ZT231/robotic-arm-vision-stm32/docs/舵机标定记录.md

# 机械臂舵机标定记录

> 本文档记录六路舵机的真实脉宽上下限与安装方向，用于：
> 1. 防止过角度碰撞（软限位 clamp 的依据）；
> 2. 计算 HOME 中位（使用实测中位宏 `SERVO_J?_MID`）；
> 3. 作为项目「标定」证据，供简历/答辩引用。
>
> 对应代码：`Core/Src/arm_control.c` 中的 `servo_min[] / servo_max[] / servo_mid[]`，
> 其数值来源即本表与 `Core/Inc/main.h` 中的 `SERVO_J?_MIN/MAX/MID` 宏。
>
> ⚠️ 本表已于 **2026-09-12** 与 `Core/Inc/main.h` 实测宏逐一复核一致
> （依据：第 3 节的实测采样记录）。改代码只需维护 main.h 宏，本文档随表核对。

---

## 一、标定结果汇总（实测，非估计值）

| 关节 | 舵机型号 | 限位下限 MIN (µs) | 限位上限 MAX (µs) | 中位 HOME (µs) | 物理行程说明 |
|:---:|:---:|:---:|:---:|:---:|:---|
| J1 基座 | 25KG 数字舵机 270° | 800 | 2300 | 1550 | 左右各约 90° |
| J2 大臂 | 25KG 数字舵机 270° | 750 | 2150 | 1470 | 前/后倾各约 90°，两端大臂约与平台平行 |
| J3 小臂 | 25KG 数字舵机 270° | 520 | 2500 | 1500 | 实测 520(逆 110°)~2500(顺 130°) |
| J4 腕俯仰 | 25KG 数字舵机 270° | 520 | 2500 | 1500 | 实测 520(顺 100°)~2500(逆 130°) |
| J5 腕旋转 | MG996R 180° | 500 | 2500 | 1450 | MG996R，顺时针 70°，逆时针 82° |
| J6 夹爪 | MG996R 180° | 900 | 2100 | 1500 | 受夹爪机械结构限制，900=张开极限，2100=闭合极限 |

> HOME 中位使用 `main.h` 中**独立实测中位宏** `SERVO_J?_MID`，
> `Arm_Init()` 直接读取该表（`home_pulse[i] = servo_mid[i]`），**不是** (MIN+MAX)/2 的算术平均
> （J2/J3/J4/J5 的中位均与算术平均不同，必须用实测值）。上表仅供人工核对。

> ⚠️ 端点说明：J3/J4 的 **500µs 端点实测无效**（舵机不动/抖动），故 MIN 取 520µs；
> J5 的 500µs 端点实测可用，保持 500~2500µs 不变。

---

## 二、标定方法与步骤（可复现）

> 标定工具：串口助手通过 UART1 发送 `$MOVE,<ch>,<pulse>*<ck>` 微调，配合本机 `$STATE*57` 读取当前脉宽。协议见《串口联调测试清单》。

### 通用流程（对每个关节重复）

1. **上电回 HOME**：发送 `$HOME*0F`，确认机械臂回到中位。
2. **切手动确认畅通**：发送 `$MANUAL*1A`，确保处于手动态。
3. **逐步逼近下限**：对目标关节，从小到大发送 `$MOVE,<ch>,pulse`，每次步进 20~50µs；
   观察机械臂，取「结构到位、再继续会碰撞/卡死」前一档为 **MIN**。
4. **逐步逼近上限**：同理从大到小逼近，取卡死前一档为 **MAX**。
5. **确认方向**：记录正方向对应的脉宽增减（如「脉宽增大→关节向左」），供上位机逆解/示教用。
6. **复核安全**：发送一次 `$MOVE,<ch>,MIN或MAX±50`，确认不越界、不抖动。

### 单轴 MOVE 校验值速查（校验值已按协议 v1 算好，可直接复制）

| 关节 | 到下限附近 | 到中位 | 到上限附近 |
|---|---|---|---|
| J1 | `$MOVE,0,800*19` | `$MOVE,0,1550*20` | `$MOVE,0,2300*20` |
| J2 | `$MOVE,1,750*12` | `$MOVE,1,1470*22` | `$MOVE,1,2150*26` |
| J3 | `$MOVE,2,520*14` | `$MOVE,2,1500*27` | `$MOVE,2,2500*24` |
| J4 | `$MOVE,3,520*15` | `$MOVE,3,1500*26` | `$MOVE,3,2500*25` |
| J5 | `$MOVE,4,500*10` | `$MOVE,4,1450*25` | `$MOVE,4,2500*22` |
| J6 | `$MOVE,5,900*1D` | `$MOVE,5,1500*20` | `$MOVE,5,2100*27` |

---

## 三、标定记录 CSV（随过程填写）

> 另存为 `docs/calibration_points.csv`，如实记录测量过程中的有效采样点，作为可量化佐证。
> 下表采样点为标定过程实测记录，与第 1 节汇总表一致。

```csv
axis,pulse_us,direction_note,observed
J1,800,left_hard_stop,ok_no_stall
J1,1550,center,ok
J1,2300,right_hard_stop,ok_no_stall
J2,750,forward_hard_stop,ok_no_stall
J2,1470,center,ok
J2,2150,back_hard_stop,ok_no_stall
J3,520,back_hard_stop,ok_no_stall
J3,1500,center,ok
J3,2500,forward_hard_stop,ok_no_stall
J4,520,forward_hard_stop,ok_no_stall
J4,1500,center,ok
J4,2500,back_hard_stop,ok_no_stall
J5,500,cw_hard_stop,ok_no_stall
J5,1450,center,ok
J5,2500,ccw_hard_stop,ok_no_stall
J6,900,gripper_open,ok_no_stall
J6,1500,gripper_half,ok_no_stall
J6,2100,gripper_closed,ok_no_stall
```

> 说明：`observed` 取值建议统一用 `ok_no_stall`（正常且无堵转）/ `stall`（有堵转，需要前移）/ `collision`（碰撞，立即记录并回退）。

---

## 四、如何把标定结果同步回代码

只需维护 `Core/Inc/main.h` 的六个 `SERVO_J?_MIN/MAX/MID` 宏，其余自动生效：

```c
/* 每路舵机的脉宽实测标定上下限与中位（us，按机械臂实际行程标定） */
#define SERVO_J1_MIN  800U
#define SERVO_J1_MAX  2300U
#define SERVO_J1_MID  1550U
#define SERVO_J2_MIN  750U
#define SERVO_J2_MAX  2150U
#define SERVO_J2_MID  1470U
#define SERVO_J3_MIN  520U
#define SERVO_J3_MAX  2500U
#define SERVO_J3_MID  1500U
#define SERVO_J4_MIN  520U
#define SERVO_J4_MAX  2500U
#define SERVO_J4_MID  1500U
#define SERVO_J5_MIN  500U
#define SERVO_J5_MAX  2500U
#define SERVO_J5_MID  1450U
#define SERVO_J6_MIN  900U
#define SERVO_J6_MAX  2100U
#define SERVO_J6_MID  1500U
```

改后无需改动 `arm_control.c`，软限位 / 中位 / 手动档位映射会同步更新。

---

## 五、安全注意事项

- 标定时务必**舵机独立供电、与 STM32 共地**，避免电流冲击 MCU 或 PCA9685。
- 逼近限位时**步进要小（≤50µs）、有停顿观察**，堵转（stall 声/电流增大）立即回退，防止烧舵机。
- J3/J4 的 500µs 端点实测无效，不要下探到 500；J5 的 500µs 端点可用但**单次不宜长时间堵转**（MG996R 电流大）。
- 标定过程建议全程录像，副产品可直接用于答辩素材。

---

## 更新记录

| 日期 | 变更说明 |
|---|---|
| 2026-09-02 | 初始录入六路标定值 |
| 2026-09-12 | 依据实测采样记录与 `Core/Inc/main.h` 实测宏全面复核：更新六轴 MIN/MAX/MID（J1 800~2300/1550、J2 750~2150/1470、J3 520~2500/1500、J4 520~2500/1500、J5 500~2500/1450、J6 900~2100/1500）；HOME 中位改述为独立 `SERVO_J?_MID` 宏（非算术平均）；J3/J4 注明 500µs 端点无效；舵机型号按实测更正（J1~J4 为 25KG 270°，J5~J6 为 MG996R 180°）；校验值速查表重新计算 |

*本表为实测标定值，与固件宏同步维护。*
