ZT231/robotic-arm-vision-stm32/vision/chessboard.png

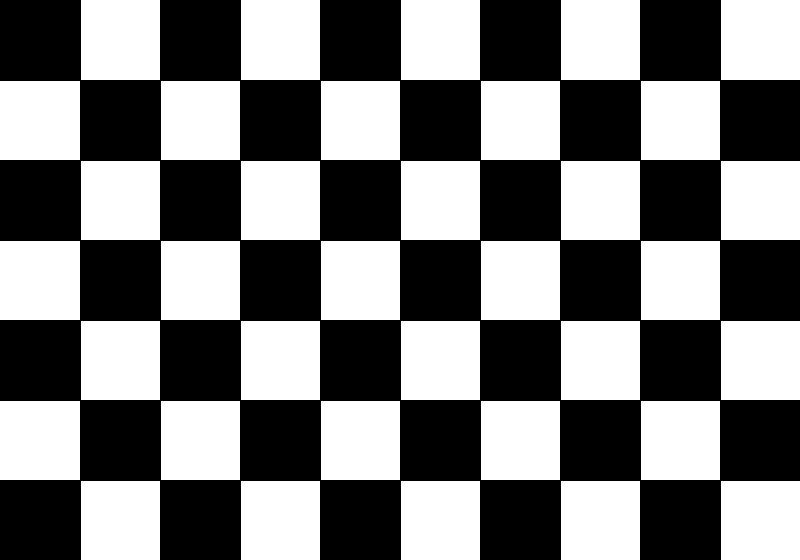
vision/chessboard.png
