ZT231/robotic-arm-vision-stm32/vision/sample.png

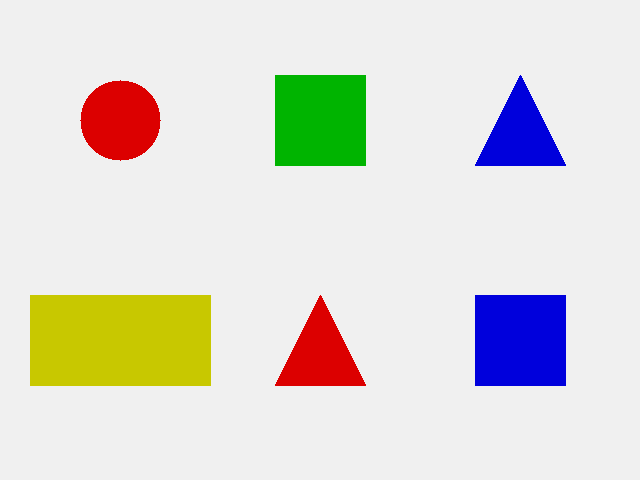
vision/sample.png
