ZT231/robotic-arm-vision-stm32/Core/Src/main.c

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
/* Includes ------------------------------------------------------------------*/
#include "main.h"
#include "cmsis_os.h"
#include "adc.h"
#include "dma.h"
#include "i2c.h"
#include "usart.h"
#include "gpio.h"

/* USER CODE BEGIN Includes */
#include "pca9685.h"
#include "potentiometer.h"
#include "arm_control.h"
#include "uart_protocol.h"
#include "bt.h"
#include "wifi.h"
#include "teach.h"
#include "rfid.h"
#include <stdio.h>
#include <string.h>
/* USER CODE END Includes */


/* USER CODE BEGIN PV */
/* 注：原主循环的运动/打印任务及共用状态变量已迁移到 freertos.c 的各任务中。
 * 这里保留初始化相关量（如果需要）。 */
/* USER CODE END PV */

void SystemClock_Config(void);
void MX_FREERTOS_Init(void);
/**
  * @brief  The application entry point.
  * @retval int
  */
int main(void)
{

  /* MCU Configuration--------------------------------------------------------*/

  /* Reset of all peripherals, Initializes the Flash interface and the Systick. */
  HAL_Init();

  /* Configure the system clock */
  SystemClock_Config();

  /* Initialize all configured peripherals */
  MX_GPIO_Init();
  MX_DMA_Init();
  MX_I2C1_Init();
  MX_USART1_UART_Init();
  MX_USART2_UART_Init();
  MX_USART3_UART_Init();
  MX_ADC1_Init();
  /* USER CODE BEGIN 2 */
  if (PCA9685_Init(&hi2c1) != HAL_OK)
  {
    printf("PCA9685 init failed\r\n");
    Error_Handler();
  }

  /* 控制核心：计算 HOME 位并上电输出安全位 */
  Arm_Init();

  /* 电位器 DMA 采样启动并预热滑动窗口 */
  Pot_Init(&hadc1);

  /* UART 指令协议：使能串口中断接收（USART1=PC/OrangePi，USART2=蓝牙，USART3=WiFi） */
  UartProto_Init(&huart1);
  BT_Init(&huart2);
  WIFI_Init(&huart3);

  /* RC522 射频卡：初始化 GPIO 软件 SPI（版本校验失败会打印但不阻塞后续流程） */
  if (RFID_Init() == HAL_OK)
  {
    printf("RC522 RFID init OK\r\n");
  }
  else
  {
    printf("RC522 RFID init FAILED (check wiring/PB0,PB12~PB15)\r\n");
  }

  /* 示教回放模块：清空轨迹缓冲 */
  Teach_Init();

  printf("Robot arm ready. Hold HOME (idle, wait CMD).\r\n");
  printf("Protocol: $CMD*ck\\r\\n (PING/STATE/HOME/STOP/RESUME/MANUAL/MOVE/JOINT/REC/RECEND/PLAY/TNUM/CLEAR)\r\n");

  /* 注：此后交由 FreeRTOS 调度器接管。
   * 原 20ms 舵机任务 / 5ms 协议任务 / 3000ms 打印任务 见 freertos.c。 */
  /* USER CODE END 2 */

  /* Init scheduler */
  osKernelInitialize();  /* Call init function for freertos objects (in cmsis_os2.c) */
  MX_FREERTOS_Init();

  /* Start scheduler */
  osKernelStart();

  /* We should never get here as control is now taken by the scheduler */

  /* Infinite loop */
  /* USER CODE BEGIN WHILE */
  while (1)
  {
    /* USER CODE END WHILE */

    /* USER CODE BEGIN 3 */
    /* 控制已移交 FreeRTOS 调度器（osKernelStart 后永不返回），
     * 主循环仅作空转占位。具体任务见 freertos.c：
     *   - StartServoTask   20ms 舵机/按键/示教/刷卡
     *   - StartProtocolTask   5ms 串口协议响应
     *   - StartPrintTask   3000ms 状态打印 */
  }
  /* USER CODE END 3 */
}

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
/* USER CODE BEGIN 4 */
//printf输出重定向
int fputc(int ch, FILE *f)
{
    HAL_UART_Transmit(
        &huart1,
        (uint8_t *)&ch,
        1,
        HAL_MAX_DELAY
    );
    return ch;
}
/* USER CODE END 4 */

/**
  * @brief  Period elapsed callback in non blocking mode
  * @note   This function is called  when TIM6 interrupt took place, inside
  * HAL_TIM_IRQHandler(). It makes a direct call to HAL_IncTick() to increment
  * a global variable "uwTick" used as application time base.
  * @param  htim : TIM handle
  * @retval None
  */
void HAL_TIM_PeriodElapsedCallback(TIM_HandleTypeDef *htim)
{
  if (htim->Instance == TIM6)
  {
    HAL_IncTick();
  }
}

/**
  * @brief  This function is executed in case of error occurrence.
  * @retval None
  */
void Error_Handler(void)
{
  /* USER CODE BEGIN Error_Handler_Debug */
  /* User can add his own implementation to report the HAL error return state */
  __disable_irq();
  while (1)
  {
  }
  /* USER CODE END Error_Handler_Debug */
}
#ifdef USE_FULL_ASSERT
/**
  * @brief  Reports the name of the source file and the source line number
  *         where the assert_param error has occurred.
  * @param  file: pointer to the source file name
  * @param  line: assert_param error line source number
  * @retval None
  */
void assert_failed(uint8_t *file, uint32_t line)
{
  /* USER CODE BEGIN 6 */
  /* User can add his own implementation to report the file name and line number,
     ex: printf("Wrong parameters value: file %s on line %d\r\n", file, line) */
  /* USER CODE END 6 */
}
#endif /* USE_FULL_ASSERT */
