ZT231/robotic-arm-vision-stm32/Core/Inc/main.h

#define KEY0_Pin GPIO_PIN_4
#define KEY0_GPIO_Port GPIOE
#define RC522_RST_Pin GPIO_PIN_0
#define RC522_RST_GPIO_Port GPIOB
#define RC522_CS_SDA_Pin GPIO_PIN_12
#define RC522_CS_SDA_GPIO_Port GPIOB
#define SCK_Pin GPIO_PIN_13
#define SCK_GPIO_Port GPIOB
#define MISO_Pin GPIO_PIN_14
#define MISO_GPIO_Port GPIOB
#define MOSI_Pin GPIO_PIN_15
#define MOSI_GPIO_Port GPIOB
#define SERVO_STEP_US  25U     /* 每 20ms 最大步进，调大就快 */
#define SERVO_J1_MIN  800U    /* 基座：左右各约90度 */
#define SERVO_J1_MAX  2300U
#define SERVO_J2_MIN  750U    /* 大臂：机械臂顺时针90°，逆时针90° */
#define SERVO_J2_MAX  2150U
#define SERVO_J3_MIN  520U    /* 小臂：实测 520(逆110°)~2500(顺130°) */
#define SERVO_J3_MAX  2500U
#define SERVO_J4_MIN  520U    /* 腕部俯仰：实测 520(顺100°)~2500(逆130°) */
#define SERVO_J4_MAX  2500U
#define SERVO_J5_MIN  500U    /* 腕部旋转：MG996R，顺时针70°，逆时针82° */
#define SERVO_J5_MAX  2500U
#define SERVO_J6_MIN  900U   /* 夹爪：受结构限制，实测900（夹爪张开到极限）~2100（闭合到极限） */
#define SERVO_J6_MAX  2100U
#define SERVO_J1_MID  1550U
#define SERVO_J2_MID  1470U
#define SERVO_J3_MID  1500U
#define SERVO_J4_MID  1500U
#define SERVO_J5_MID  1450U
#define SERVO_J6_MID  1500U
