ZT231/robotic-arm-vision-stm32/(commit log)

2026-10-16 STM32F407 六自由度机械臂视觉抓取系统
2026-10-16 修正 RC522 软件 SPI 相关注释与文档表述，统一电位器平均点数注释
    [potentiometer.c, rfid.c]
